palmerr23/reflowOvenController/images/Menu.jpg

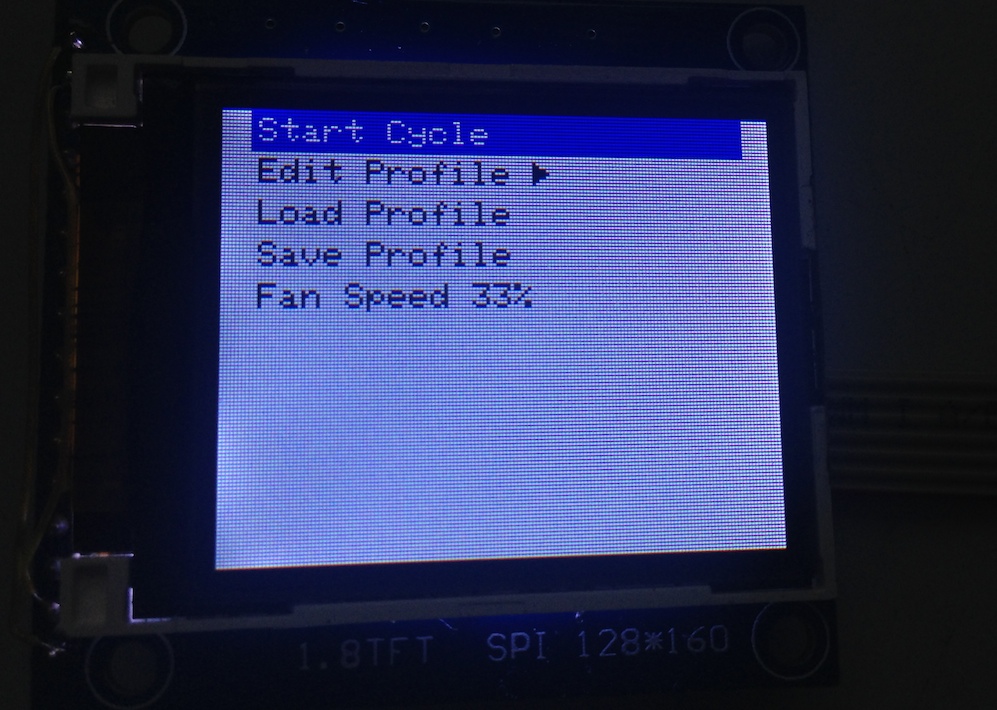
images/Menu.jpg
