palmerr23/reflowOvenController/images/Completed1.jpg

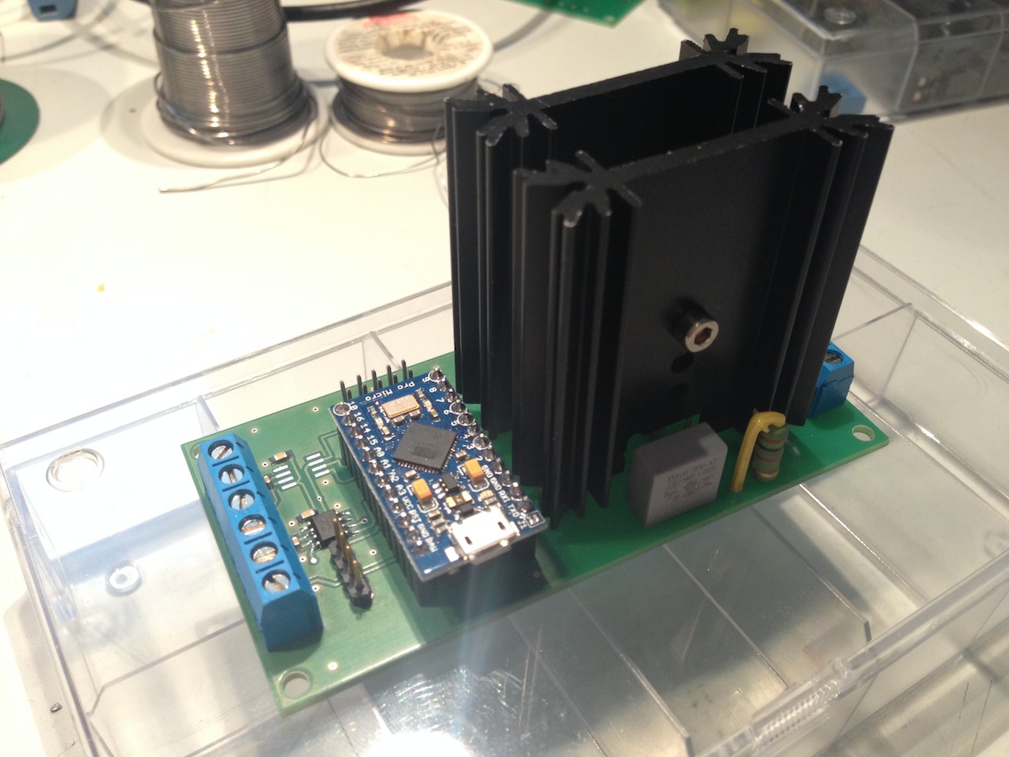
images/Completed1.jpg
