palmerr23/reflowOvenController/README.md

Reflow Oven Controller
====================

**News**

Karl's main branch is at https://github.com/0xPIT/reflowOvenController

Forked here at https://github.com/palmerr23/reflowOvenController-1
