palmerr23/reflowOvenController/images/Completed2.jpg

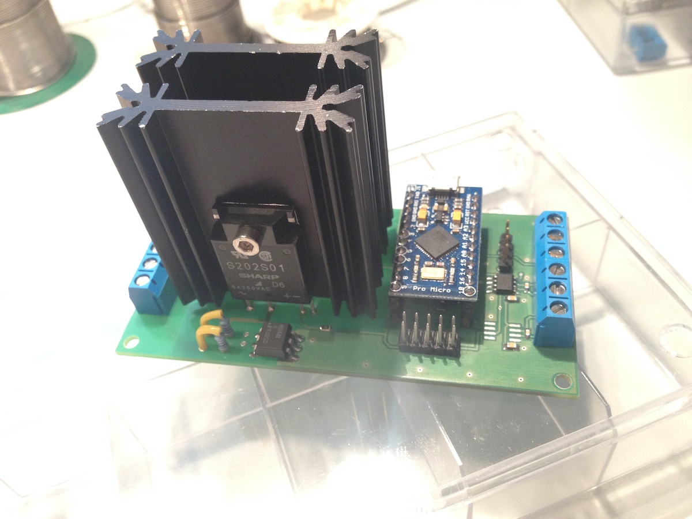
images/Completed2.jpg
