palmerr23/reflowOvenController/images/CycleWithOverflow.jpg

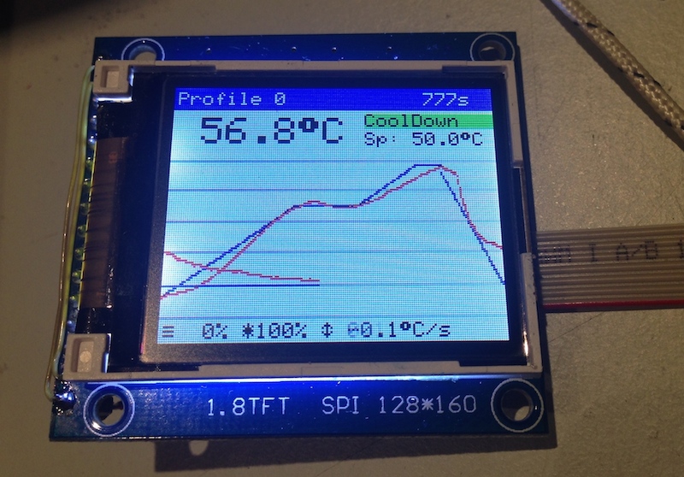
images/CycleWithOverflow.jpg
