palmerr23/reflowOvenController/images/FanSpeedEdit.jpg

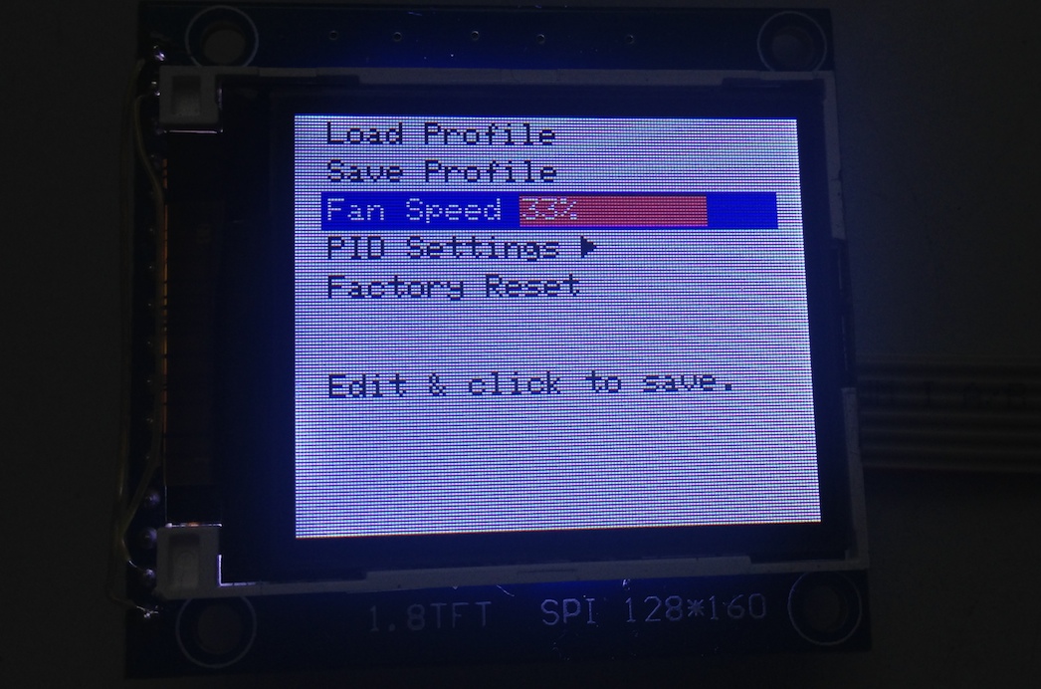
images/FanSpeedEdit.jpg
