palmerr23/reflowOvenController/images/MenuEditProfile.jpg

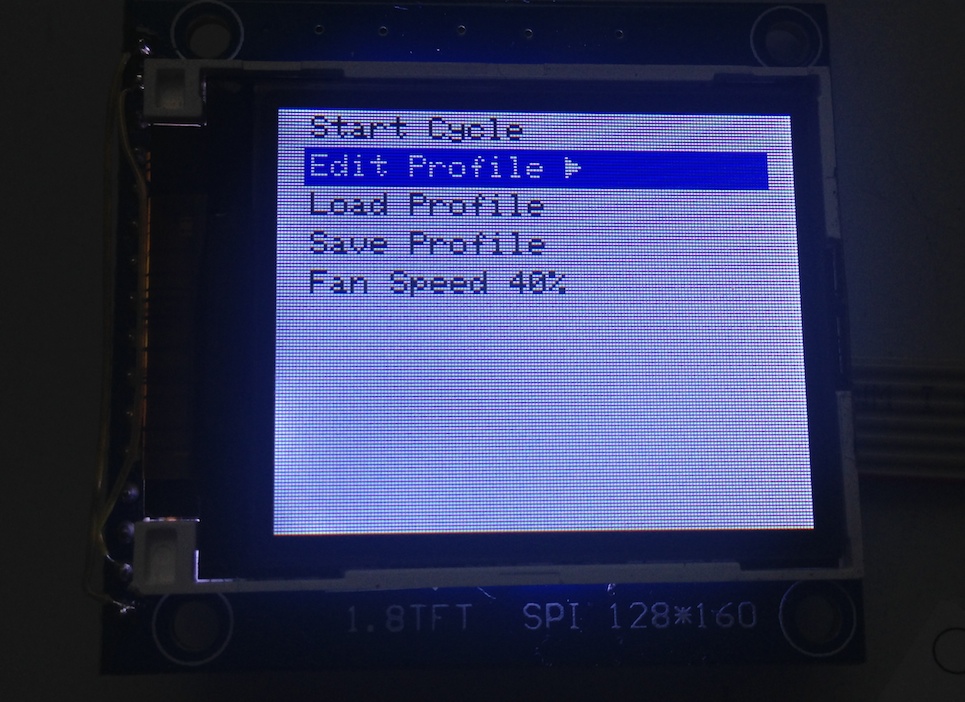
images/MenuEditProfile.jpg
