palmerr23/reflowOvenController/images/MenuLoadProfile.jpg

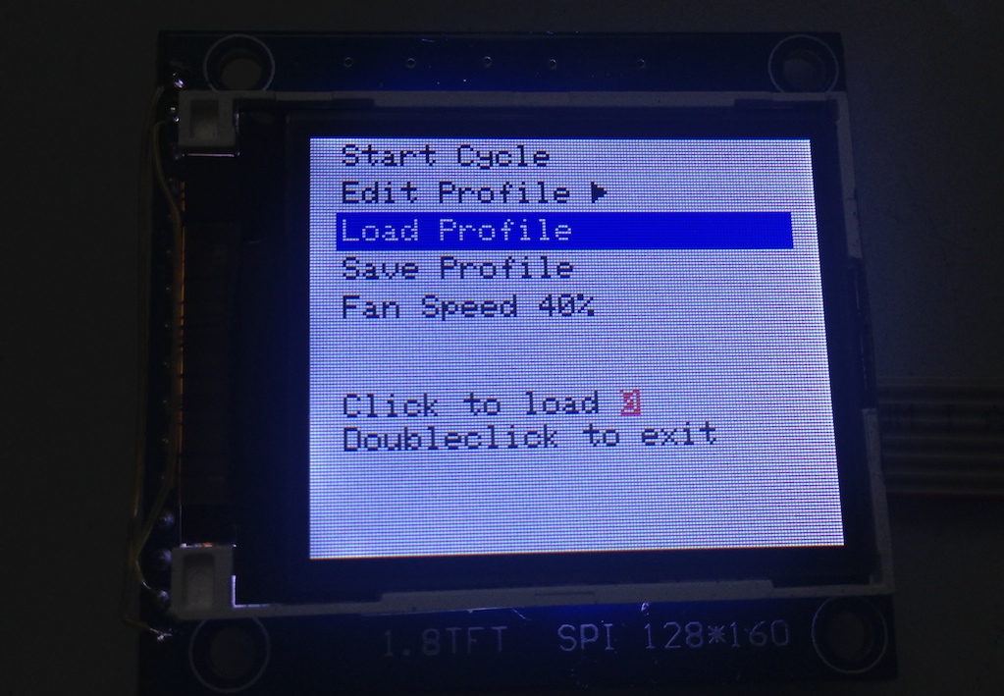
images/MenuLoadProfile.jpg
