palmerr23/reflowOvenController/images/MissingTrace.jpg

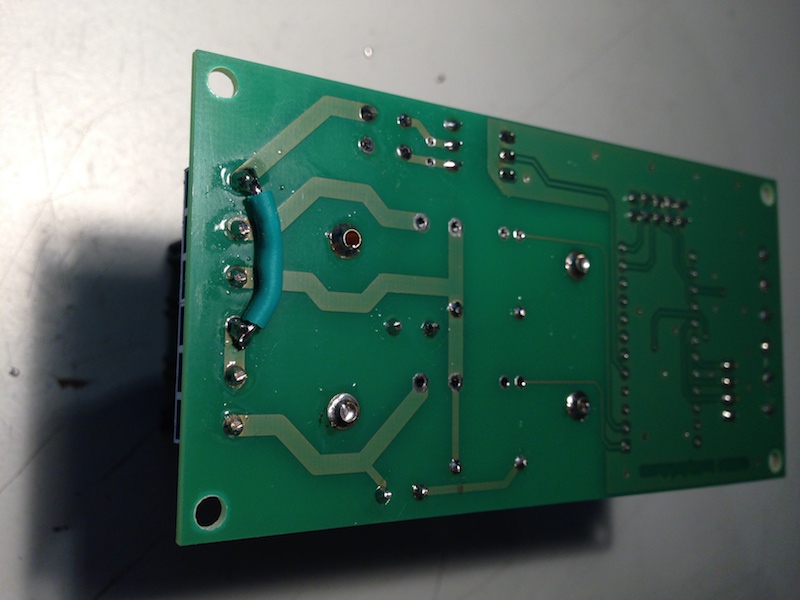
images/MissingTrace.jpg
