palmerr23/reflowOvenController/images/PIDValues.jpg

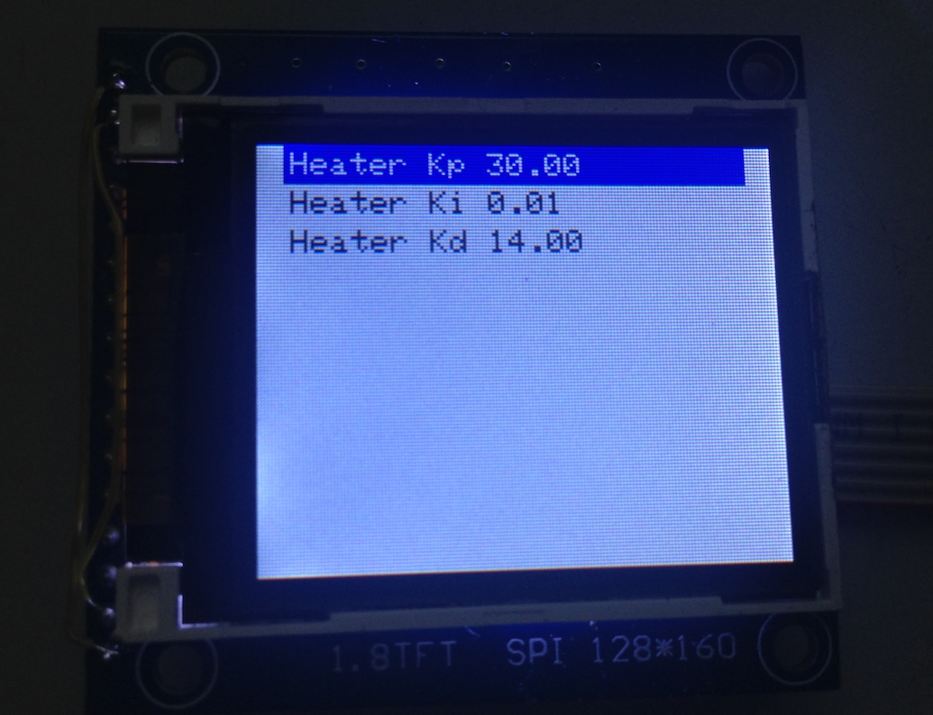
images/PIDValues.jpg
