palmerr23/reflowOvenController/images/ProfileSettings.jpg

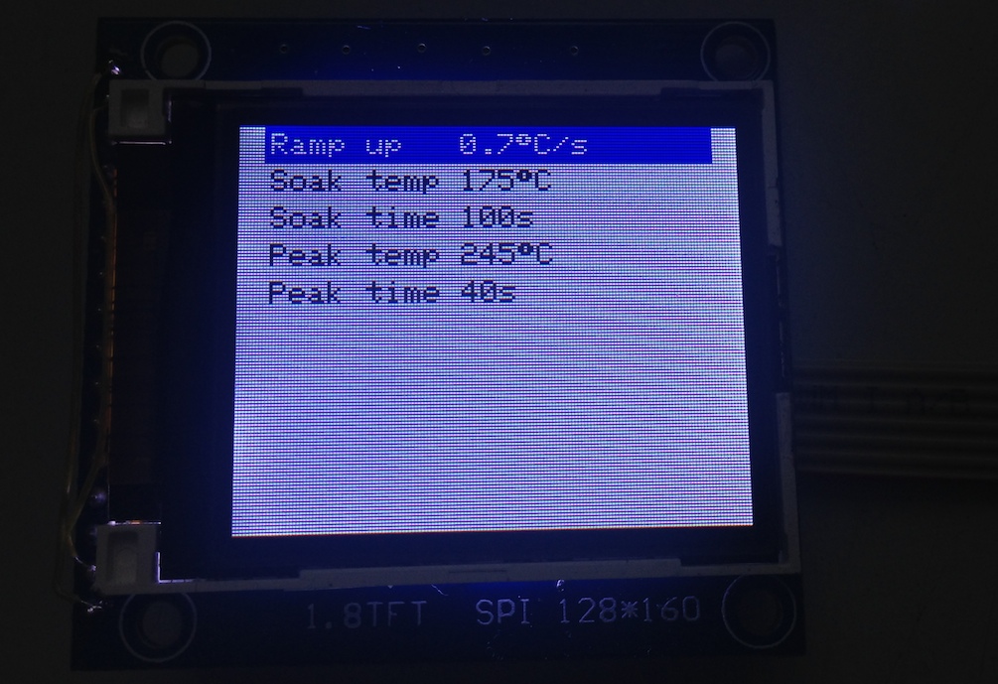
images/ProfileSettings.jpg
