palmerr23/reflowOvenController/(commit log)

2014-05-17 cleanup and initial draft of encoder ui
2014-05-17 use PID library as submodule
2014-05-17 Revert "use PID library as submodule"
    This reverts commit c3c390a266937635d6f1a086e45819d075db5f97.
2014-05-17 introduce USE_CLICKENCODER to select between classic behaviour and click encoder ui
2014-05-17 support encoder acceleration when editing values
2014-05-19 add hardware files
    [ReflowController.brd, ReflowController.sch]
2014-05-20 prepare wave packet control; cleanup;
    [ReflowController.sch]
2014-05-21 PCB rev2: add noise filter cap; increase size of snubber caps
    [ReflowController.brd, ReflowController.sch]
2014-05-21 - refactor - add hardwaare config for pit hardware - addpremain code to ensure SSRs are off - use native io instead of arduinos for performance in isr
2014-06-01 - add zero cross logic - added simple phase control in addition to wave packet control - use zero cross interrupt for timing instead of millis() - refactor to remove hardware variants - externalize l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
    [ReflowController.brd, ReflowController.sch]
2014-06-03 heavy refactor for gfx lcd and own menu system
    [ReflowController.brd, ReflowController.sch]
2014-06-03 refactor state machine remove second thermocouple as it was unused anyway simple right align for temperatue values cleanup & cosmetics
2014-06-06 fix state machine; new process display; separate helper code in new file; refactorings
    [helpers.h, temperature.h]
2014-06-08 improved ftoa(), moved crc8 to helpers.h, introducte FAKE_HW for testing on development board; pid parameters are now configurable; fixed clearLastItemstate;
    [helpers.h]
2014-06-08 refactor; save some space; fix edit menu update
    [helpers.h]
2014-06-09 fix string termination in helper conversion functions
    [helpers.h]
2014-06-10 update pcb
    [ReflowController.brd, ReflowController.sch]
2014-06-11 added autotuning and compile option as it wont fit in codemem
    [ReflowController.brd]
2014-06-12 update and improve pcb
    [ReflowController.brd, ReflowController.sch]
2014-06-13 add v0.2 sch and pcb preview images
2014-06-17 experimantal support for 60Hz mains
2014-07-07 add missing trace
    [ReflowController.brd]
2014-07-12 add bom
2014-07-12 fix csv
    [bom.csv]
2014-07-12 fix bom
    [bom.csv]
2014-07-14 - improved zero cross loop calculation - add fault tolerance for flaky thermocouple when powered with noisy smps - cleaner thermocouple code - refactor load/save screen to save flash space - eemem ch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
    [temperature.h]
2014-07-14 - improved zero cross loop calculation … - add fault tolerance for flaky thermocouple when powered with noisy smps - cleaner thermocouple code - refactor load/save screen to save flash space - eemem 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
2014-07-14 improve zx loop delay calibration
2014-07-16 fix startup pin level; configurable calibratinon loop, not set to fixed value;
2015-01-09 rename arduino project file; thx Lucas
2015-06-08 Update optocoupler type in BOM
    [bom.csv]
2015-09-27 Update ReflowController.ino
    reference new PID code.
2015-09-27 Create Oven_PID.h
    Revised PID Code
2015-09-27 Create Oven_PID.cpp
    PID Code update
